Gualor/PSoC-Final-Project/(commit log)

2020-05-17 Added project top design
    [AY1920_II_HW_06.sdf]
2020-05-17 Added InterruptRoutines .h and .c files containing ISR functions for handling button functionalities.
2020-05-18 Added SPIM component to top design, create SPI related files for basic readings from LIS3DH
    [AY1920_II_HW_06.sdf, AY1920_II_HW_FINAL_CARZANIGA_GUALNIERA.sdf]
2020-05-18 Added LED_Driver.h and .c files with utility functions for driving LED RGB.
    [AY1920_II_HW_FINAL_CARZANIGA_GUALNIERA.sdf]
2020-05-19 Optimized top design. Debugged button functionalities.
    [AY1920_II_HW_FINAL_CARZANIGA_GUALNIERA.sdf]
2020-05-19 Fixed bug with inverted RGB value for driving common anode LED.
    [AY1920_II_HW_FINAL_CARZANIGA_GUALNIERA.sdf]
2020-05-20 Final commit for LED_Driver issue. General code refactoring.
    [AY1920_II_HW_FINAL_CARZANIGA_GUALNIERA.sdf]
2020-05-20 Deleted led_driver branch.
2020-05-22 Added LIS3DH reading FIFO, need to be fixed coordination with others ISR
    [AY1920_II_HW_FINAL_CARZANIGA_GUALNIERA.sdf]
2020-05-22 Reprogramming button logic in hardware, ISR_START is now triggered by a double click event
    [AY1920_II_HW_FINAL_CARZANIGA_GUALNIERA.sdf]
2020-05-24 Overthreshold setup registers and related ISR
    [AY1920_II_HW_FINAL_CARZANIGA_GUALNIERA.sdf]
2020-05-24 Added high-level functions to read/write internal state and logs inside EEPROM pages.
    [AY1920_II_HW_FINAL_CARZANIGA_GUALNIERA.sdf]
2020-05-24 Fixed bug with data type conversion of Moving_Average function.
    [LED_Driver.c]
2020-05-24 Added LogUtils.h and .c files with utility functions to create log messages to be stored in the EEPROM memory.
    [AY1920_II_HW_FINAL_CARZANIGA_GUALNIERA.sdf]
2020-05-25 Added EEPROM_resetMemory function and minor fix of other EEPROM utility functions
    [AY1920_II_HW_FINAL_CARZANIGA_GUALNIERA.sdf]
2020-05-25 Added RGB_sendFlagNotify function to drive blue channel of RGB LED when setting the send flag to EEPROM.
2020-05-25 Added local queue to store 6 IMU FIFO at the time, downsampled by 2 the signals in order to be stored in EEPROM
    [AY1920_II_HW_FINAL_CARZANIGA_GUALNIERA.sdf]
2020-05-26 Added high-level EEPROM utility functions (tested). Increased SPIM EEPROM bit rate to avoid reading issues.
    [AY1920_II_HW_FINAL_CARZANIGA_GUALNIERA.sdf]
2020-05-27 Added functions to log the internal queue inside EEPROM when over threshold occurrs.
    [AY1920_II_HW_FINAL_CARZANIGA_GUALNIERA.sdf]
2020-05-27 Fixed bug with multiple ISR occurrences. Added switch case in main.c to handle internal state logic.
    [AY1920_II_HW_FINAL_CARZANIGA_GUALNIERA.sdf]
2020-05-28 Changed PWM logic to greater or equal to fix RGB_Stop function bug.
    [AY1920_II_HW_FINAL_CARZANIGA_GUALNIERA.sdf]
2020-05-28 Added start/stop functionalities for IMU interrupts events. Fixed bug with ADC conversion.
    [main.c]
2020-05-29 Added bridge control panel files and comments to each file, updated .gitignore
    [AY1920_II_HW_FINAL_CARZANIGA_GUALNIERA.sdf]
2020-05-31 Added UART receiver ISR to parse and execute remote commands to read/write to the EEPROM memory.
    [AY1920_II_HW_FINAL_CARZANIGA_GUALNIERA.sdf]
2020-05-31 Added python script for remote EEPROM debug
    [AY1920_II_HW_FINAL_CARZANIGA_GUALNIERA.sdf]
2020-06-01 added button_logic image
